sebastian-wong/WearableTechnology_Embedded-System-Design-Project/README.md

# littleboy
Experimental application

To create a wearable device to provide in-building navigation guidance for a visually-impaired person. For more information, please refer to the readme pdf inside this repository.
