sebastian-wong/WearableTechnology_Embedded-System-Design-Project/Hardware/arduino ide/gyro(7nov)/gyroscope_reading/Compass_hcm5883l/gyroscope_reading/compass.h

#ifndef compass.h
  #define compass.h
  
  #include "compass.h"
  
  extern float bearing;
  extern float compass_x_scalled;
  extern float compass_y_scalled;
  extern float compass_z_scalled;
  
  extern float compass_x_offset, compass_y_offset, compass_z_offset;
  extern float compass_x_gainError,compass_y_gainError,compass_z_gainError;
  
  extern int compass_debug;
  
  void compass_read_XYZdata();
  void compass_calibration(int select);
  void compass_init(int gain);
  void compass_scalled_reading();
  void compass_heading();
  
  
#endif
