sebastian-wong/WearableTechnology_Embedded-System-Design-Project/(commit log)

2014-10-01 Housekeeping
    Cleared and stored files
    [README.configure.txt]
2014-10-08 UART (sample)
    UART code shown during demo (week 7)
2014-10-08 UART (sample)
    moved files into UART folder
2014-10-08 correct uart on rpi
    [rpiarduart3.py]
2014-10-11 Audiofeedback class
    Improved feedback speed by using threading
2014-10-11 Ultrasound, Short range IR , Barometer (Arduino)
    latest update of code for ultrasound, IR and barometer with libraries
    files required
    other sensors working in progress to output relevant info.
    [BMP085test.ino, IR_9oct.ino, ultrasound.ino]
2014-10-12 Edit error in speech thread
2014-10-13 Keypad in progress (not working yet)
    [Keypad.cpp, Keypad.h, keypad_updated_version_.ino]
2014-10-14 keypad (still in progress >.< not working)
    [keypad_updated_version_.ino]
2014-10-14 UART(working)
    stop-and-wait UART.
2014-10-15 Compass / Magnetometer Working ^^
    accuracy up to +-5 degree in most cases
2014-10-16 Update Routing Algorithm to receive UART info
    Awaiting real-time testing and integration
    Awaiting voice-recognition integration! :)
2014-10-17 vibration motor
    this is just a test. still require an interpreter file to check the
    distance sense by the sensors and vibrate the motors at different rates.
    [motor.ino]
2014-10-18 Long range IR
    Works ok for range between 80 to 320cm
2014-10-18 UART update (w/numpad integrated)
    added number pad into UART
2014-10-18 UART comm return value for sensors
    awaiting for function for the voice/keypad input
2014-10-18 modified UART code
    -to return values in py
    -modified activate voice flag in ardiono
2014-10-18 Revert "modified UART code"
    This reverts commit 411610f071fd72fb7722ed87eea15097eef35a51.
    [arduino_UART_latest.ino]
2014-10-18 modified UART code
    -modified rpiUartComm.py to return values
    -modified ardiono_UART avtivate voice flag
2014-10-18 UART rpi
    clean up code
    comment functions
    removed writing actuator codes to arduino
2014-10-19 UART update
    -- changed number of sensor data to send to 24
    -- added timer into get_sensor_data
2014-10-19 UART changed(size of data)
    changed size of data to be received by Rpi to 25
2014-10-19 Updated to suit new settings from UART comm
2014-10-22 new motor code
2014-10-24 edited sensor_poll_loop accordingly to the number of sensors used this coming sat demo
2014-10-24 Repaired sensorPin assignment to reading
2014-10-24 Motors vibrate linearly based on sensor distances
    [SensorPollGeneralLoopSliding.ino]
2014-10-24 Actual workable UART
2014-10-24 UART with obstacle avoidance, no keypad-pedo
    [UART_with_obstacle_avoidance.ino]
2014-10-25 edited sensorPin assignment to reading
2014-10-25 simple case keypad edited
    for keypad number 1 to activate pedo
2014-11-03 combination with 1 ir sensor and 1 motor
2014-11-04 gyro raw data code
2014-11-07 sample program with keyboard input for testing
2014-11-07 gyro + compass
2014-11-08 all sensors working tgt
2014-11-13 working arduino side
2014-11-13 all sensors, including pedo, working with UART
2014-11-15 removed timestamp and while loop in gyrocompass
